lgabci/avrprog/avrprog-pcb/avrprog-pcb.kicad_pcb

## KiCad design avrprog-pcb/avrprog-pcb.kicad_pcb (2021-04-07)

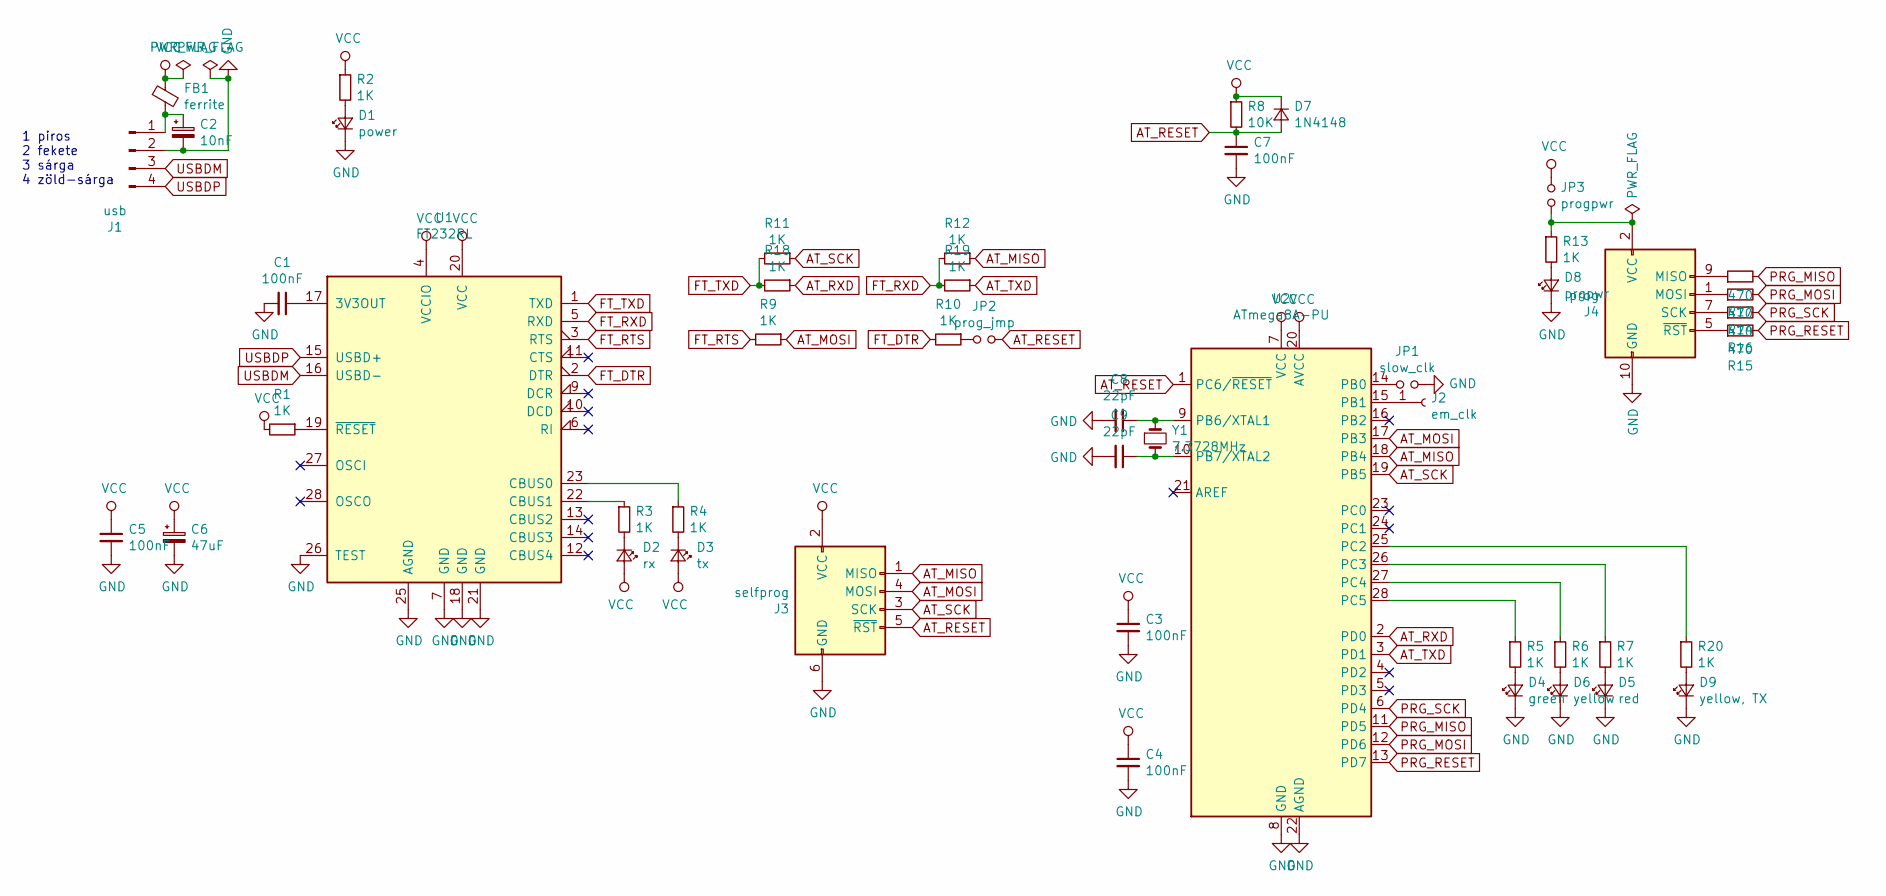
[picture p1: schematic avrprog-pcb.sch]

Parts:
C1, C3, C4, C5, C7: 100nF; C_Rect_L7.2mm_W2.5mm_P5.00mm_FKS2_FKP2_MKS2_MKP2
C2: 10nF; C_Disc_D5.0mm_W2.5mm_P2.50mm
C6: 47uF; CP_Radial_D6.3mm_P2.50mm
C8, C9: 22pF; C_Disc_D5.0mm_W2.5mm_P2.50mm
D1: power; LED_D3.0mm
D2: rx; LED_D3.0mm
D3: tx; LED_D3.0mm
D4: green; LED_D3.0mm
D5: red; LED_D3.0mm
D6: yellow; LED_D3.0mm
D7: 1N4148; D_DO-35_SOD27_P7.62mm_Horizontal
D8: prgpwr; LED_D3.0mm
D9: yellow, TX; LED_D3.0mm
FB1: ferrite; L_0805_2012Metric_Pad1.15x1.40mm_HandSolder
J1: usb; PinHeader_1x04_P2.54mm_Horizontal
J2: em_clk; PinSocket_1x01_P2.54mm_Vertical
J3: selfprog; PinHeader_2x03_P2.54mm_Vertical
J4: prog; PinHeader_2x05_P2.54mm_Vertical
JP1: slow_clk; PinHeader_1x02_P2.54mm_Vertical
JP2: prog_jmp; PinHeader_1x02_P2.54mm_Vertical
JP3: progpwr; PinHeader_1x02_P2.54mm_Vertical
R1, R2, R3, R4, R5, R6, R7, R9, R10, R11, R12, R13, R18, R19, R20: 1K; R_Axial_DIN0207_L6.3mm_D2.5mm_P7.62mm_Horizontal
R8: 10K; R_Axial_DIN0207_L6.3mm_D2.5mm_P7.62mm_Horizontal
R14, R15, R16, R17: 470; R_Axial_DIN0207_L6.3mm_D2.5mm_P7.62mm_Horizontal
U1: FT232RL; DIP-28_W15.24mm
U2: ATmega8A-PU; DIP-28_W7.62mm
Y1: 7.3728MHz; Crystal_HC49-U_Vertical

Connections:
AT_MISO: J3.1 (MISO), R12.1, U2.18 (PB4)
AT_MOSI: J3.4 (MOSI), R9.1, U2.17 (PB3)
AT_RESET: C7.1, D7.2 (A), J3.5 (~RST), JP2.2, R8.2, U2.1 (PC6/~RESET)
AT_RXD: R18.1, U2.2 (PD0)
AT_SCK: J3.3 (SCK), R11.1, U2.19 (PB5)
AT_TXD: R19.1, U2.3 (PD1)
FT_DTR: R10.2, U1.2 (DTR)
FT_RTS: R9.2, U1.3 (RTS)
FT_RXD: R12.2, R19.2, U1.5 (RXD)
FT_TXD: R11.2, R18.2, U1.1 (TXD)
GND: C1.2, C2.2, C3.2, C4.2, C5.2, C6.2, C7.2, C8.2, C9.2, D1.1 (K), D4.1 (K), D5.1 (K), D6.1 (K), D8.1 (K), D9.1 (K), J1.2, J3.6 (GND), J4.4 (GND), J4.6 (GND), J4.8 (GND), J4.10 (GND), JP1.2, U1.7 (GND), U1.18 (GND), U1.21 (GND), U1.25 (AGND), U1.26 (TEST), U2.8 (GND), U2.22 (AGND)
unnamed: C1.1, U1.17 (3V3OUT)
unnamed: C2.1, FB1.2, J1.1
unnamed: C8.1, U2.9 (PB6/XTAL1), Y1.1
unnamed: C9.1, U2.10 (PB7/XTAL2), Y1.2
unnamed: D1.2 (A), R2.2
unnamed: D2.1 (K), R3.2
unnamed: D3.1 (K), R4.2
unnamed: D4.2 (A), R5.2
unnamed: D5.2 (A), R7.2
unnamed: D6.2 (A), R6.2
unnamed: D8.2 (A), R13.2
unnamed: D9.2 (A), R20.2
unnamed: J2.1, U2.15 (PB1)
unnamed: J4.1 (MOSI), R14.1
unnamed: J4.2 (VCC), JP3.2, R13.1
unnamed: J4.5 (~RST), R15.1
unnamed: J4.7 (SCK), R16.1
unnamed: J4.9 (MISO), R17.1
unnamed: JP1.1, U2.14 (PB0)
unnamed: JP2.1, R10.1
unnamed: R1.1, U1.19 (~RESET~)
unnamed: R3.1, U1.22 (CBUS1)
unnamed: R4.1, U1.23 (CBUS0)
unnamed: R5.1, U2.28 (PC5)
unnamed: R6.1, U2.27 (PC4)
unnamed: R7.1, U2.26 (PC3)
unnamed: R20.1, U2.25 (PC2)
PRG_MISO: R17.2, U2.11 (PD5)
PRG_MOSI: R14.2, U2.12 (PD6)
PRG_RESET: R15.2, U2.13 (PD7)
PRG_SCK: R16.2, U2.6 (PD4)
USBDM: J1.3, U1.16 (USBD-)
USBDP: J1.4, U1.15 (USBD+)
VCC: C3.1, C4.1, C5.1, C6.1, D2.2 (A), D3.2 (A), D7.1 (K), FB1.1, J3.2 (VCC), JP3.1, R1.2, R2.1, R8.1, U1.4 (VCCIO), U1.20 (VCC), U2.7 (VCC), U2.20 (AVCC)

Notes on the sheet:
1 piros 2 fekete 3 sárga 4 zöld-sárga

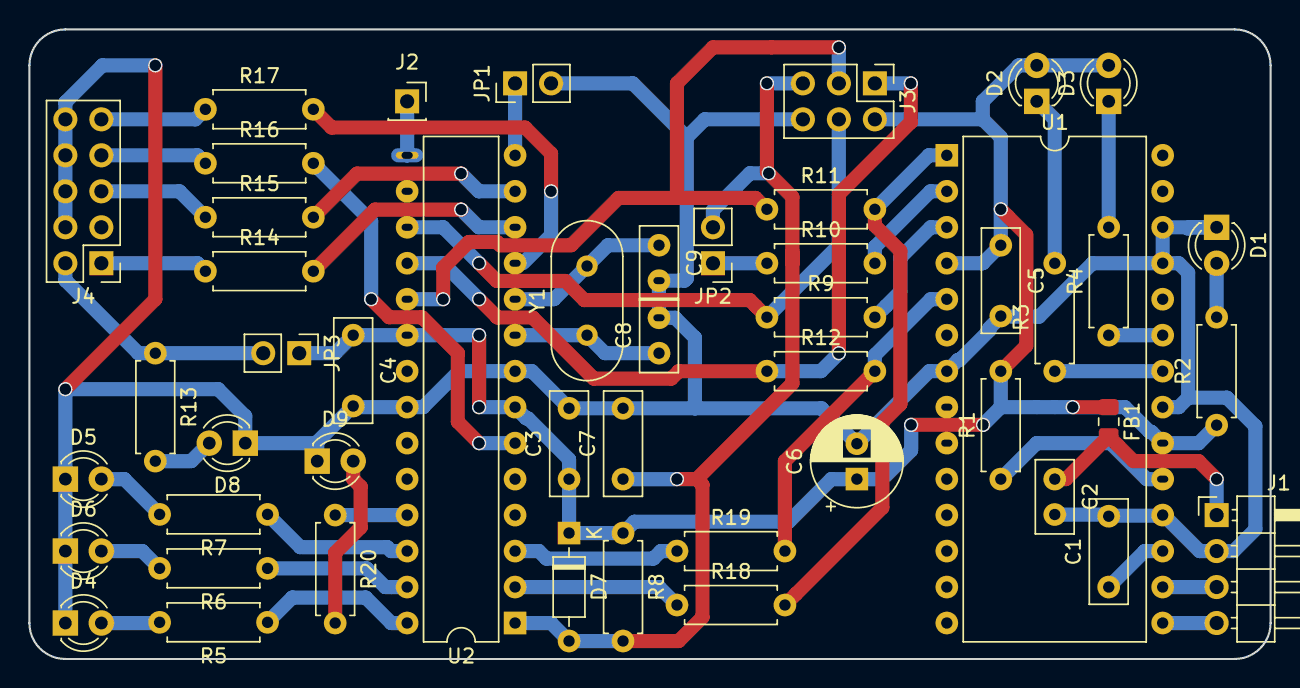
[picture p2: board avrprog-pcb.kicad_pcb from above]

Board: 2 copper layers, 87.6 x 44.5 mm, 49 parts (0 on the bottom side), 45 nets.
