lgabci/avrprog/(commit log)

2019-02-13 hardware test: 1 sec LED blinker
2019-04-19 schematic (not finished yet)
    [avrprog.sch]
2019-04-20 schematic (not finished)
    [avrprog.sch]
2019-04-22 pcb creation with kicad (not finished)
    [avrprog.kicad_pcb, avrprog.sch]
2019-04-28 pcb (not finished)
    [avrprog.kicad_pcb, avrprog.sch]
2019-05-02 pcb (gEDA schematic added)
    [avrprog.sch]
2019-05-04 - in schematic turn to geda - program odified to use 7.3728 MHz crystal instead of 8MHz internal osc
    [avrprog.kicad_pcb, avrprog.sch]
2019-05-05 PCB footprints added
    [avrprog.sch]
2019-05-06 1MHz clock output conencted to PB1(OC1A)
    [avrprog.sch]
2019-05-07 PWM on PB1
2019-05-08 emergency clock signal: 921600 Hz 50% PWM on PB1, finished
2019-05-12 SPI testing
2019-05-15 software SPI, not finished
2019-06-04 PCB: using software SPI (PC2-PC5) insteod of hardware SPI
    [avrprog.sch]
2019-06-08 component and wires rearrangement
    [avrprog.sch]
2019-06-09 PCB designing
    [avrprog.pcb, avrprog.sch]
2019-06-09 PCB finished
    [avrprog.pcb]
2019-12-21 prog.c: reordered, EEPROM handling, spi.c: nowait transmission
2019-12-25 spi.c: fix some bugs in transmission; prog.c: readOsccal, spiMulti
    [message.c, prog.c, prog.h, spi.c]
2019-12-28 LCD display removed, 4 LEDs added
2020-05-05 schematics redesigned
    [avrprog.sch]
2020-05-06 resistor value changed to 1K between FT232RL and ATmega reset pin some small visual modifications
    [avrprog.sch]
2020-05-06 transitioning to KiCad
    [avrprog-pcb.kicad_pcb, avrprog-pcb.sch, avrprog.pcb, avrprog.sch]
2020-05-07 creating PCB
    [avrprog-pcb.sch, avrprog.pcb, avrprog.sch]
2020-05-08 designing PCB
    [avrprog-pcb.kicad_pcb, avrprog-pcb.sch]
2020-05-15 PCB redesigned for smaller size transition from make to meson + ninja
    [avrprog-pcb.kicad_pcb]
2021-03-07 minor schematics fixes
    [avrprog-pcb.sch]
2021-04-06 schematics and PCB mod
    [avrprog-pcb.kicad_pcb, avrprog-pcb.sch]
2021-04-07 schematics and PCB mod connector ISP connector 10 to 6
    [avr-isp-10-6.kicad_pcb, avr-isp-10-6.sch, avrprog-pcb.kicad_pcb, avrprog-pcb.sch]
